fdcl-gwu/Motor_Tests/tiger_5_31_2018_14p8 volt/Report/Report.pdf

# Final expressions for Tiger 700 motor and 11*3.7 CF propeller with 14.8 V

### Mahdis Bisheban

### June 2, 2018

The following is from experimental data:

T hrottle = p1T

2 + p2 ∗ T + p3 | (1)
Coefficients (with 95% confidence bounds): | (2)
p1 = −1.784(−2.176, −1.392) | (3)
p2 = 38.45(34.62, 42.28) | (4)
p3 = 6.359(−0.6873, 13.4) | (5)
τ = p1T + p2 | (6)
Coefficients (with 95% confidence bounds): | (7)
p1 = 0.01351(0.01283, 0.01419) | (8)
p2 = 0.006128(0.002816, 0.009441) | (9)
(10)

The following is from motor manual:

τ = p1T + p2 | (11)
Coefficients (with 95% confidence bounds): | (12)
p1 = 0.01719(0.01498, 0.0194) | (13)
p2 = 0.005421(−0.01431, 0.02515) | (14)
(15)


Figure 1: Throttle vs thrust (N)


Figure 2: Torque (Nm) vs thrust (N)
