fdcl-gwu/Motor_Tests/my notes.docx

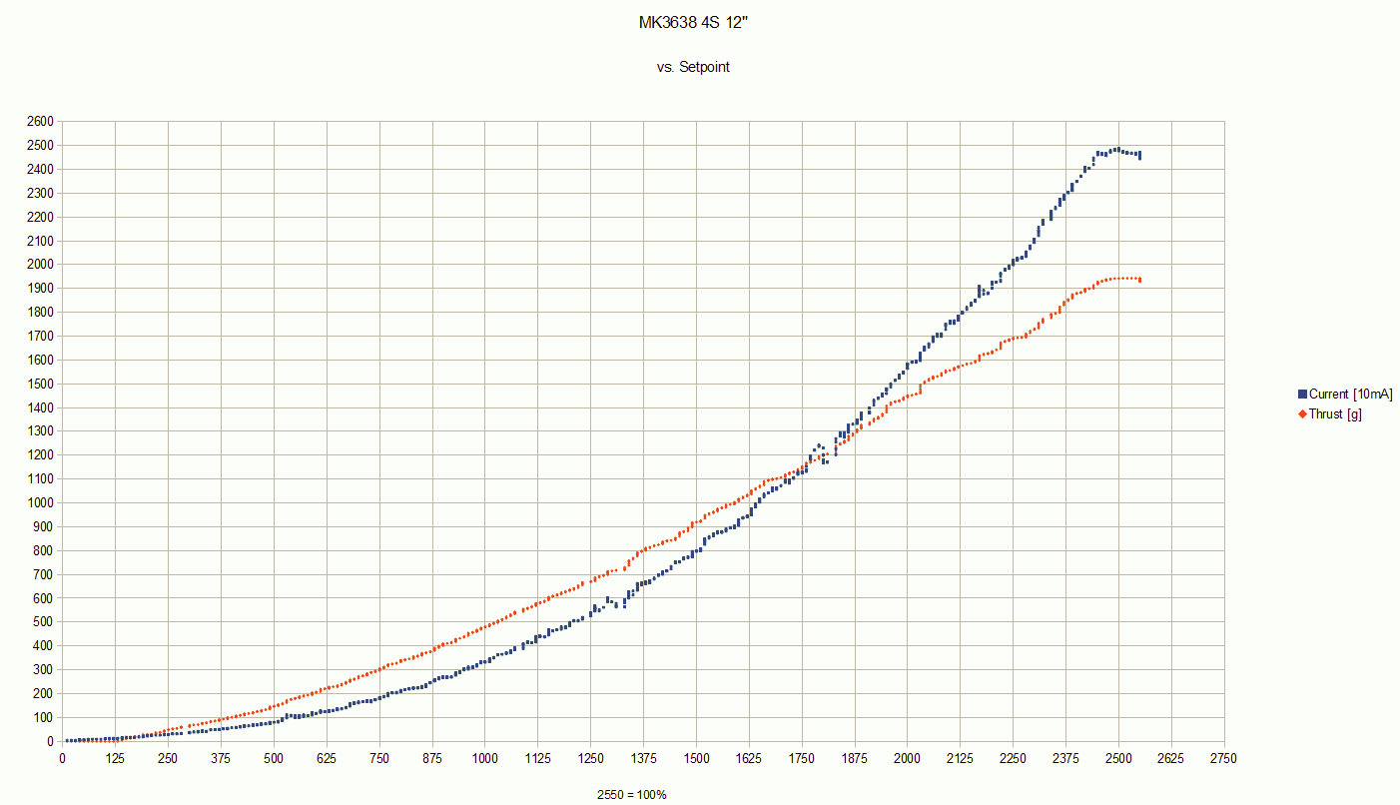
[picture p5: figure]

From http://wiki.mikrokopter.de/MK3538?action=show&redirect=MK3638

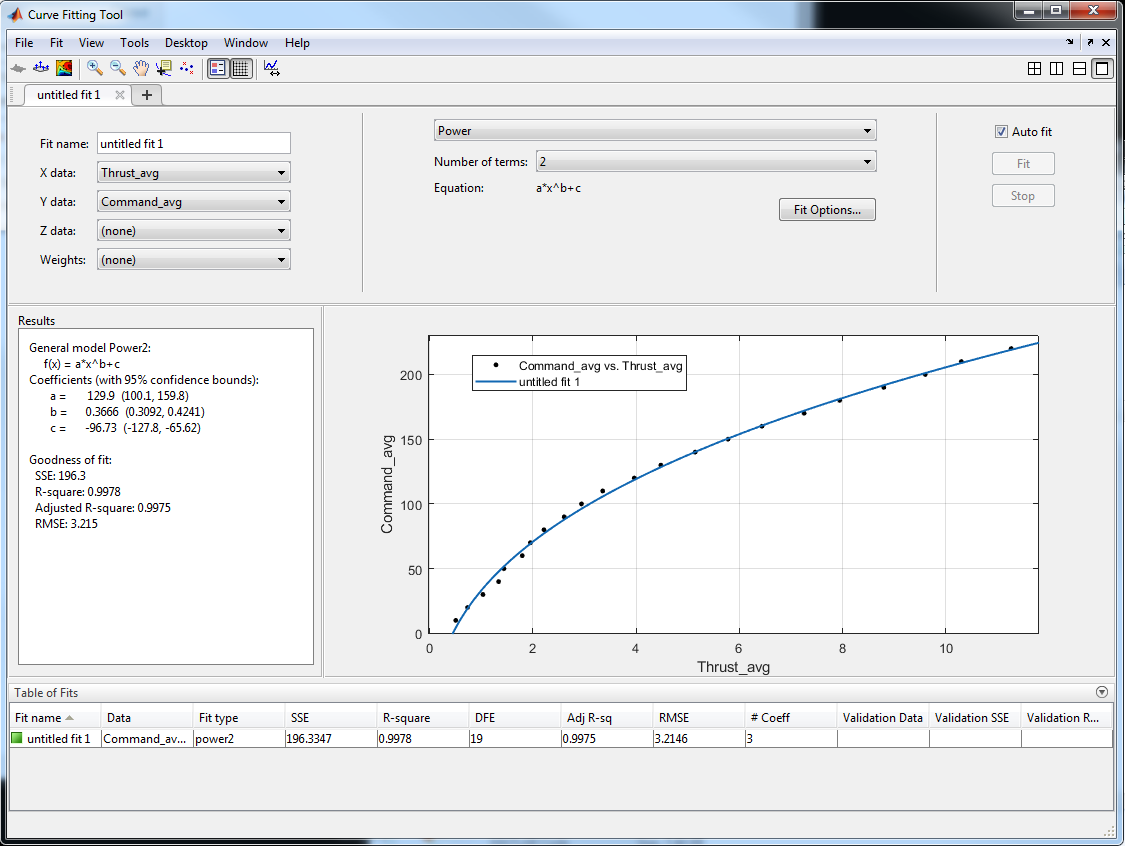
[picture p6: figure]
