fdcl-gwu/Motor_Tests/Photo_readme/calib.jpg

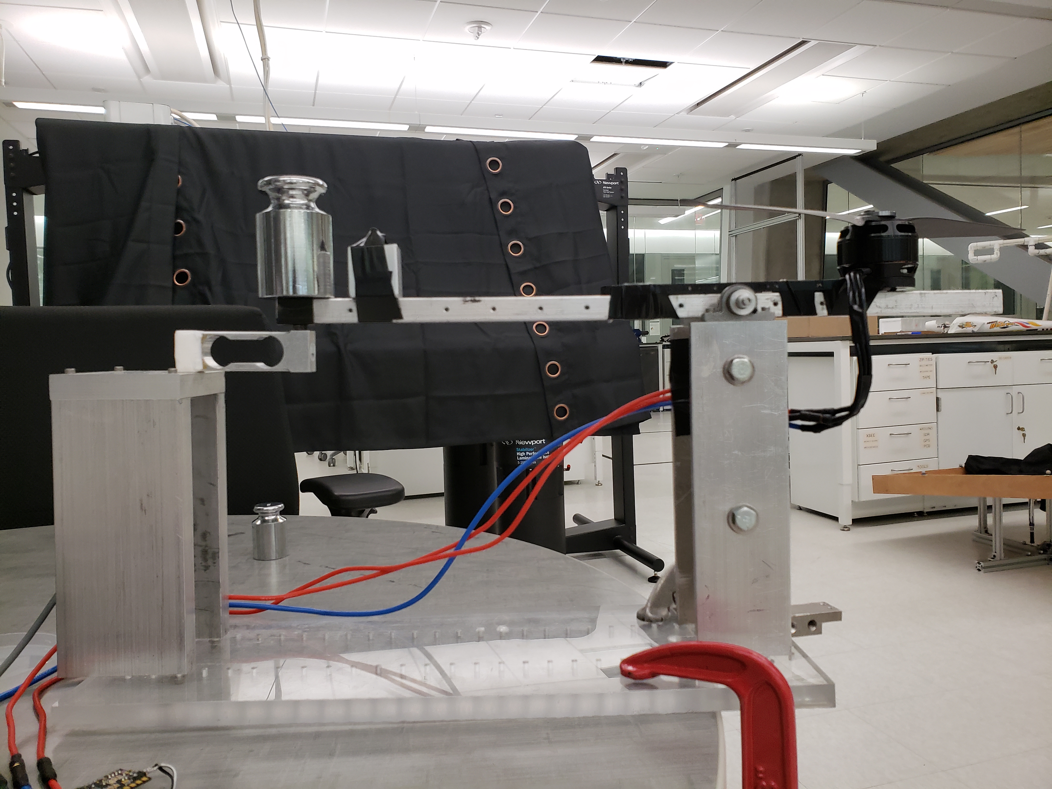
Photo_readme/calib.jpg
