fdcl-gwu/Motor_Tests/Photo_readme/import_Matlab.png

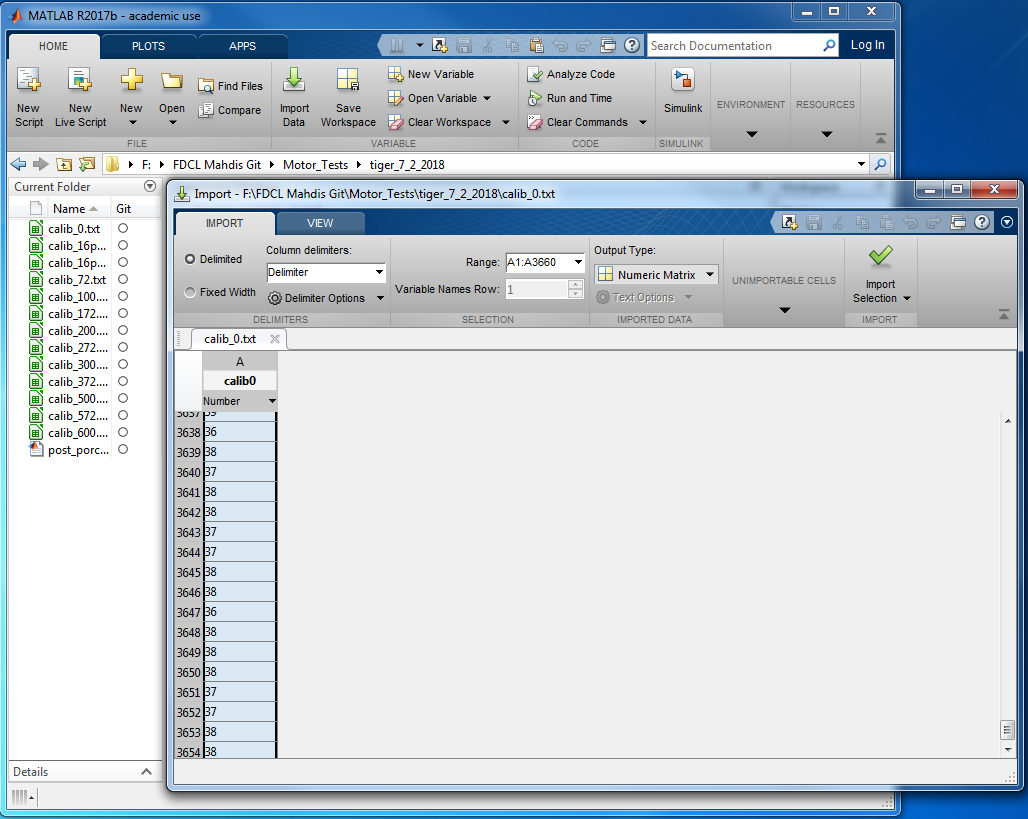
Photo_readme/import_Matlab.png
