fdcl-gwu/Motor_Tests/Photo_readme/thrust.jpg

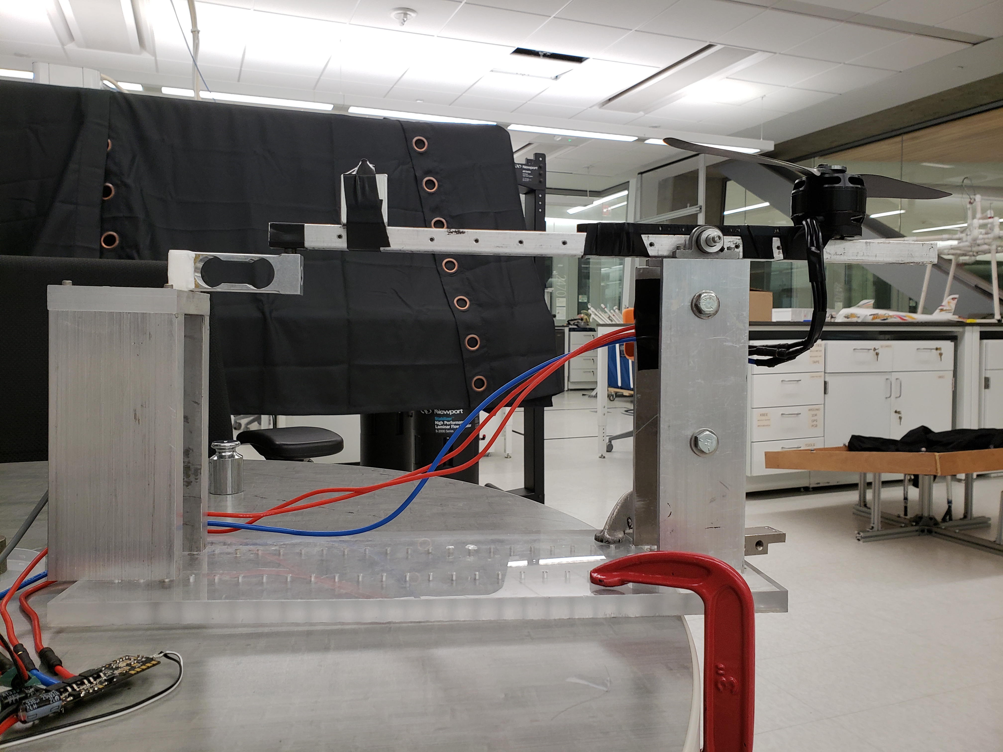
Photo_readme/thrust.jpg
