fdcl-gwu/Motor_Tests/tiger_5_31_2018_14p8 volt/Report/C_tau_1.jpg

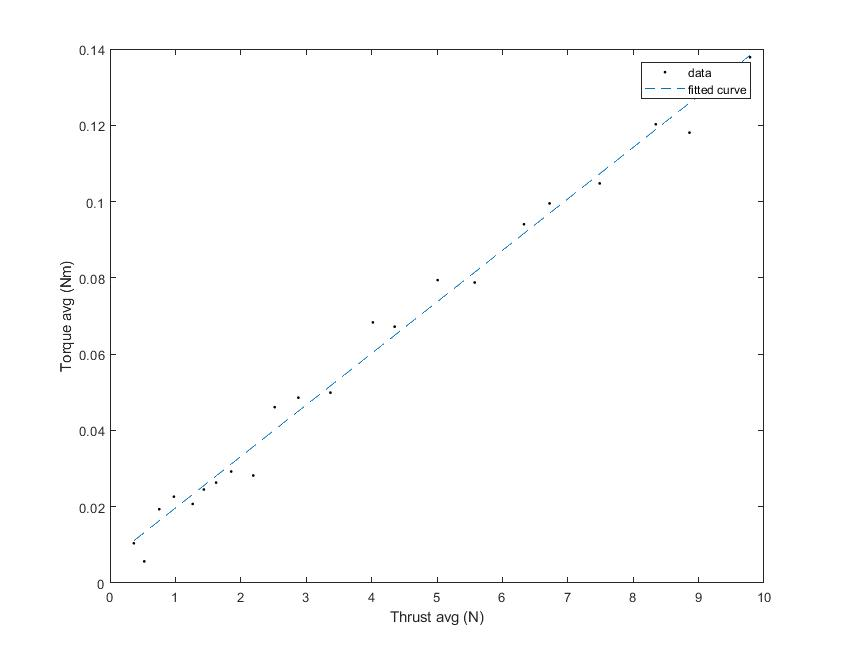
tiger_5_31_2018_14p8 volt/Report/C_tau_1.jpg
