fdcl-gwu/Motor_Tests/tiger_5_31_2018_14p8 volt/tiger_torque_data_post_process_14.8/test_V_14.8.txt

10	1	255	28	24	4	149	33
10	1	255	28	24	4	149	24
10	1	255	28	24	4	149	27
10	0	255	28	24	4	149	25
10	1	40	28	0	4	149	16
10	1	40	28	0	4	149	12
10	1	40	28	0	4	149	13
10	1	40	28	0	4	149	15
10	1	40	28	0	4	149	14
10	1	40	28	0	4	149	15
10	1	40	28	0	4	149	14
10	1	40	28	0	4	149	12
10	1	40	28	0	4	149	13
10	1	40	28	0	4	149	13
10	1	40	28	0	4	149	13
10	1	40	28	0	4	149	14
10	1	40	28	0	4	149	14
10	1	40	28	0	4	149	15
10	1	40	28	0	4	149	16
10	1	40	28	0	4	149	12
10	1	40	28	0	4	149	15
10	1	40	28	0	4	149	11
10	1	40	28	0	4	149	14
10	1	40	28	0	4	149	16
10	1	40	28	0	4	149	16
10	1	40	28	0	4	149	18
10	1	40	28	0	4	149	17
10	1	40	28	0	4	149	18
10	1	40	28	0	4	149	18
10	1	40	28	0	4	149	18
10	1	40	28	0	4	149	18
10	1	40	28	0	4	149	18
10	1	40	28	0	4	149	17
10	1	40	28	0	4	149	16
10	1	40	28	0	4	149	17
10	1	40	28	0	4	149	15
10	1	40	28	0	4	149	10
10	1	40	28	0	4	149	15
10	1	40	28	0	4	149	13
10	1	40	28	0	4	149	14
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
