fdcl-gwu/Motor_Tests/(commit log)

2018-05-29 updated the ReadMe and the path and name of the text file and adress of Arduino USB
2018-05-30 added the mfile to compute the maximum load on load cell with maximum thrust and torque of motor
2018-05-31 added result of test for C_tau (14.8 V), and the initial matlab processing mfiles
2018-05-31 updated ReadMe file and did thrust test
2018-05-31 added results of thrust
2018-05-31 processing data for torque experimnet & measuring th emaximum load on load cell
2018-05-31 data after processing of torque data added
2018-07-02 added data for 16.2V
2018-07-05 updated strain meter and load cell wires
2018-09-17 torque vs current, and rotor speed
2018-10-31 Updated readme to mention data filtering
2019-06-20 add simple motor test
2019-10-03 add calibration data for U3 motor with APC 10x4.7
2019-10-10 updat arm lengths
2019-11-22 change line fit to power2 from poly2
2019-11-24 add motor calibration for MN3110 motor and APC 10x4.7 at 16.2 Volts
2019-11-24 add motor calibration for MN3110 motor and T-Motor 9545 composite propeller
2019-11-24 add meter calibration data
